FumBlau/BlauPed/README.md

# BlauPed

Plataforma de experimentación y aprendizaje de robótica basada en MePed de Scott Pierce spiercetech.com

Modificaciones hechas por Fum Blau SCV en junio del 2017

Los archivos de diseño y corte estan protegidos por Creative Commons Sharealike (CC-BY-SA), incluida en el repositorio.
EL codigo está protegido por GPL v2 o GPL v3, el cual tienes las condiciones incluidas en este repositorio.
