FumBlau/BlauPed/(commit log)

2017-05-25 IRremote no funciona con platformio, arduino IDE otra vez :(
2017-05-25 nombres de carpeta y archivo
2017-07-25 añado instrucciones, cambio nombres de archivo a castellano
2017-07-25 retoques en pdf de instrucciones
2017-07-26 añado como calibrar servos al final del pdf
2017-07-26 retoques de maquetado
2017-07-26 estandarización de readme
2017-07-28 erratas y archivos de sobra
